IowaScaledEngineering/mss-debug/pg/mss-debug-v2.0-8bf8608/mss-debug-drc.txt

** Drc report for /home/ndholmes/data/projects/mss-debug/kicad/mss-debug/mss-debug.kicad_pcb **
** Created on 2024-08-26 14:05:44 **

** Found 0 DRC violations **

** Found 0 unconnected pads **

** Found 0 Footprint errors **

** End of Report **
