IowaScaledEngineering/mss-debug/pg/mss-debug-v2.0-8bf8608/mss-debug.pdf

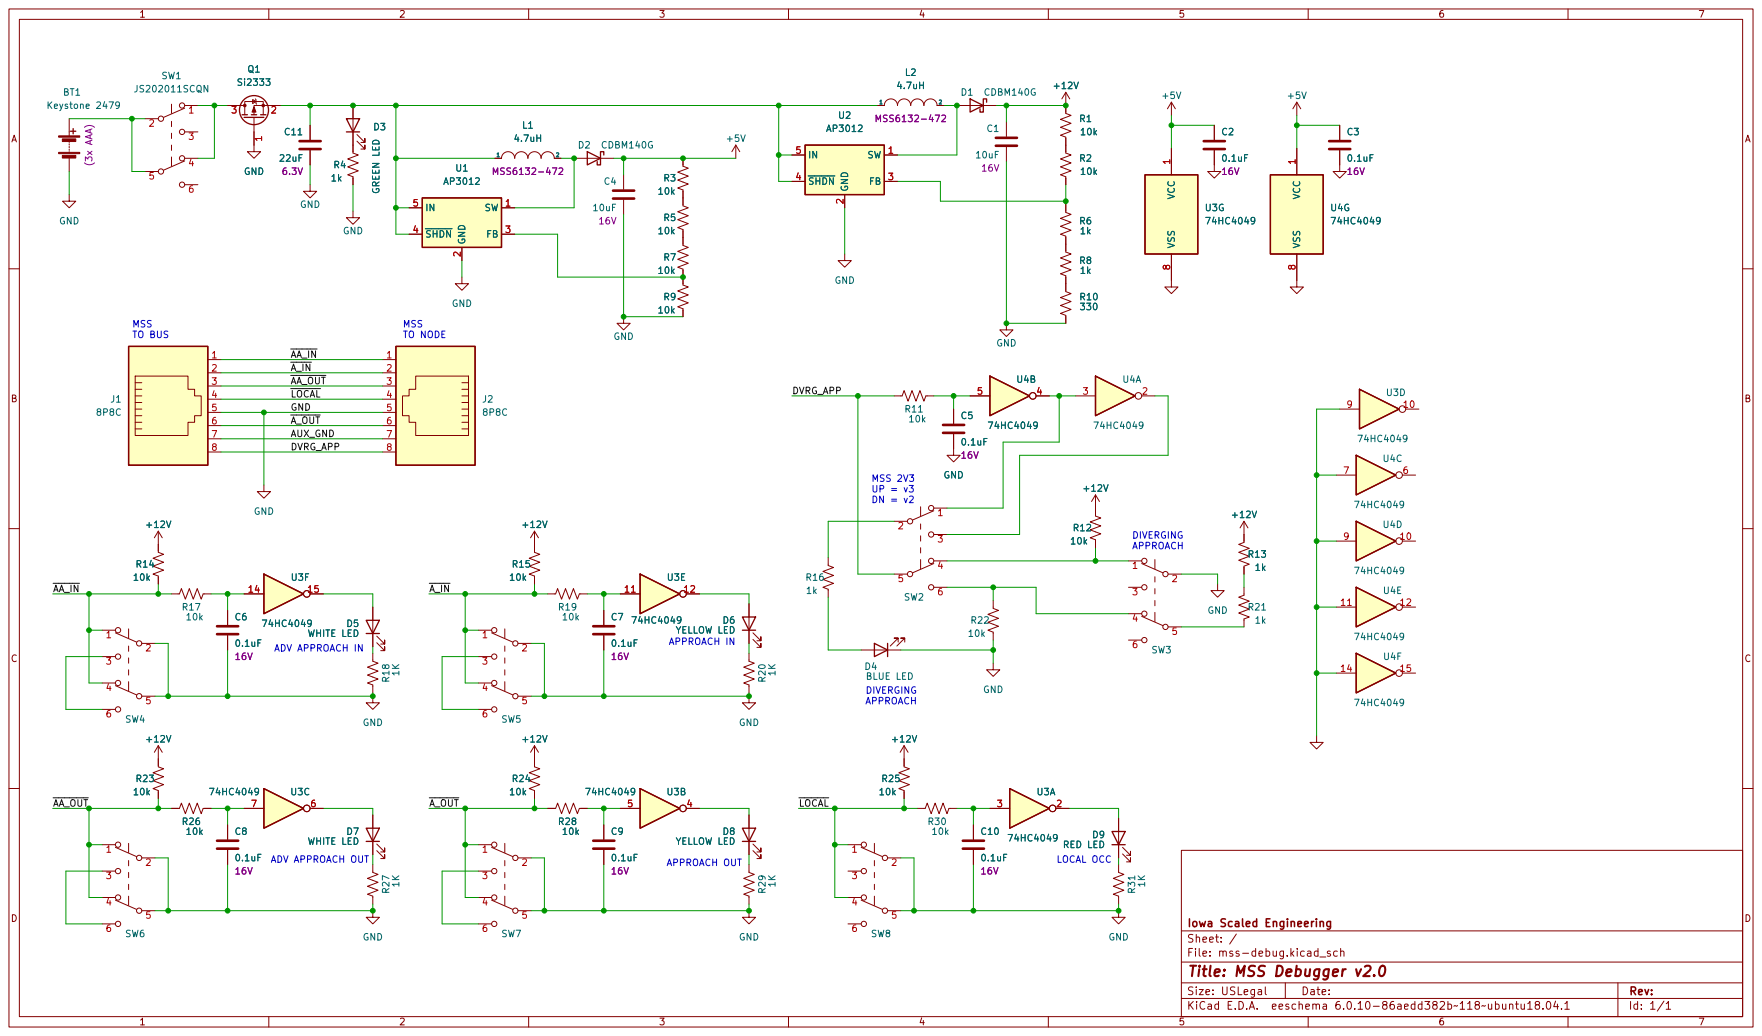
[picture p1: page 1]

ADV APPROACH IN MSS
TO BUS

6 | ~{A_OUT} 6

Iowa Scaled Engineering
File: mss-debug.kicad_sch Sheet: /
Id: 1/1 Title: MSS Debugger v2.0
