IowaScaledEngineering/mss-debug/pg/mss-debug-v1.0-e24eb0f/mss-debug-pcb.pdf

# mss-debug.pcb

# 1. Table of Contents (This Page) Created on Wed Jun 8 13:53:43 2016

# 2. component 3. solder 4. outline 5. plated-drill 6. componentmask 7. soldermask 8. topsilk 9. bottomsilk 10. toppaste 11. topassembly 12. bottomassembly 13. fab

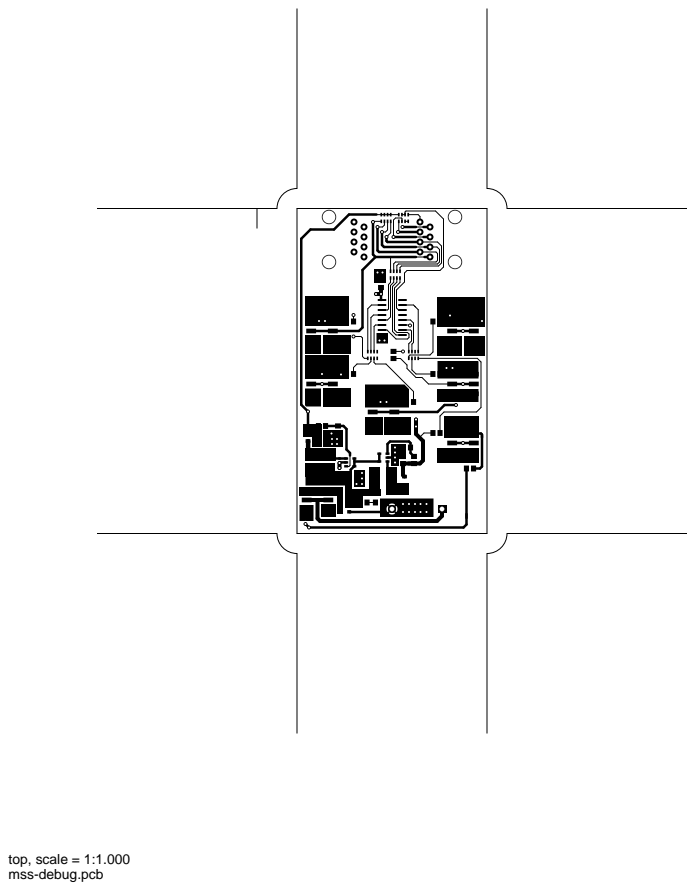
[picture p2: page 2]
top, scale = 1:1.000

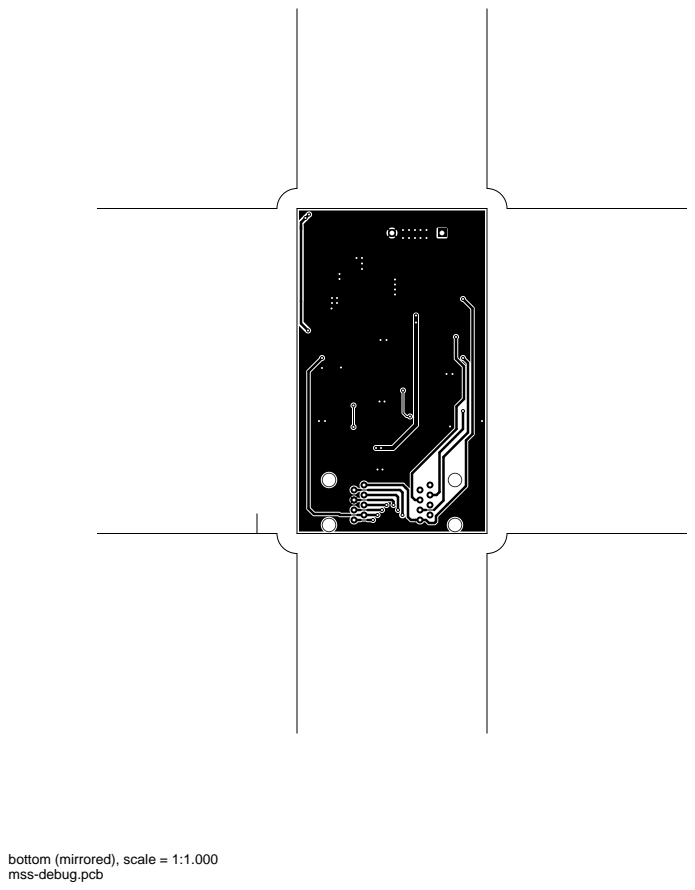
[picture p3: page 3]

bottom (mirrored), scale = 1:1.000

outline, scale = 1:1.000

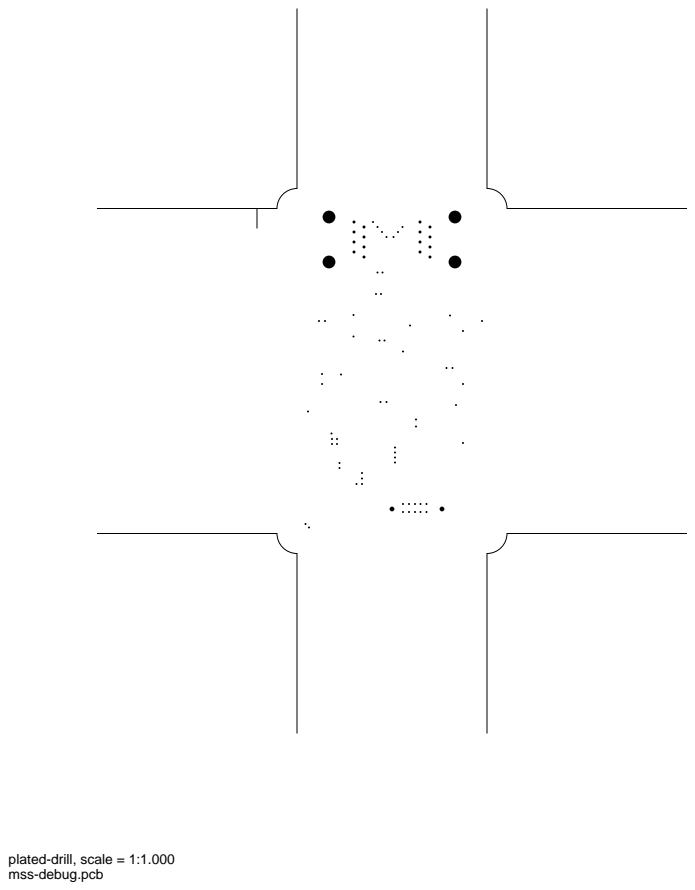
[picture p4: page 5]

plated-drill, scale = 1:1.000

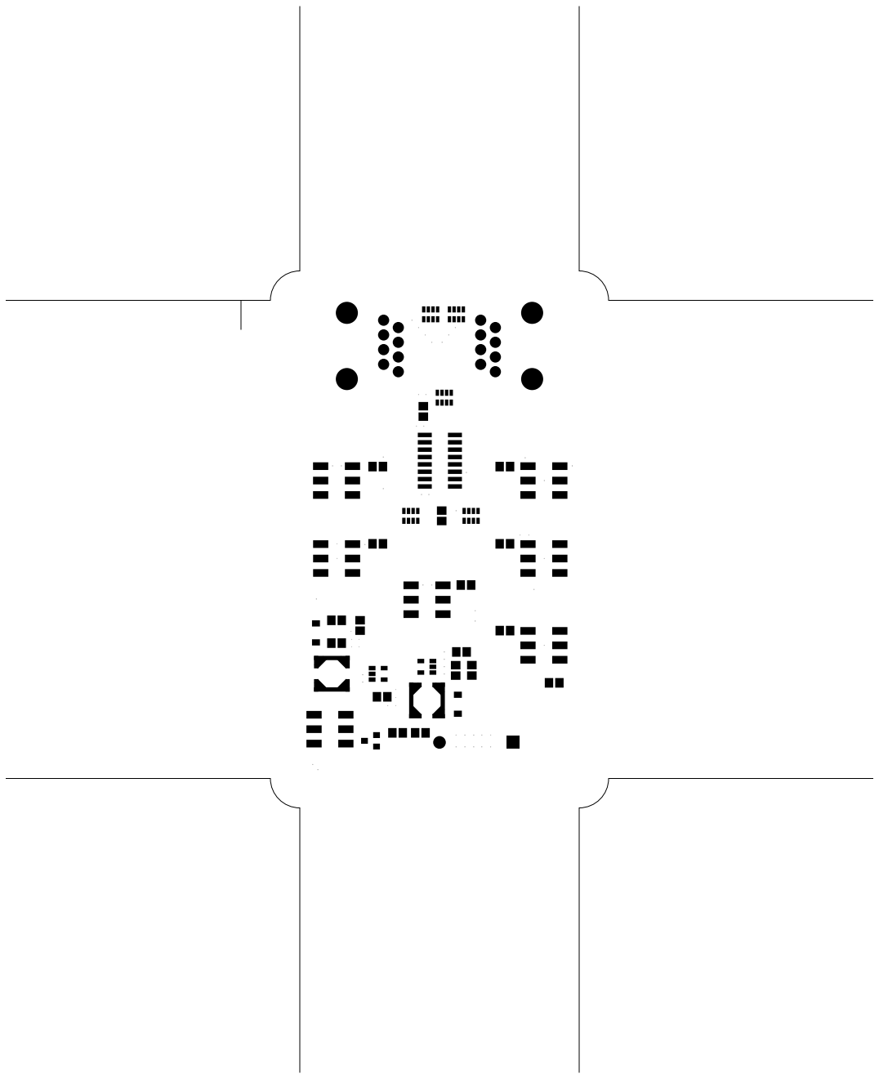
[picture p5: figure]

topmask, scale = 1:1.000

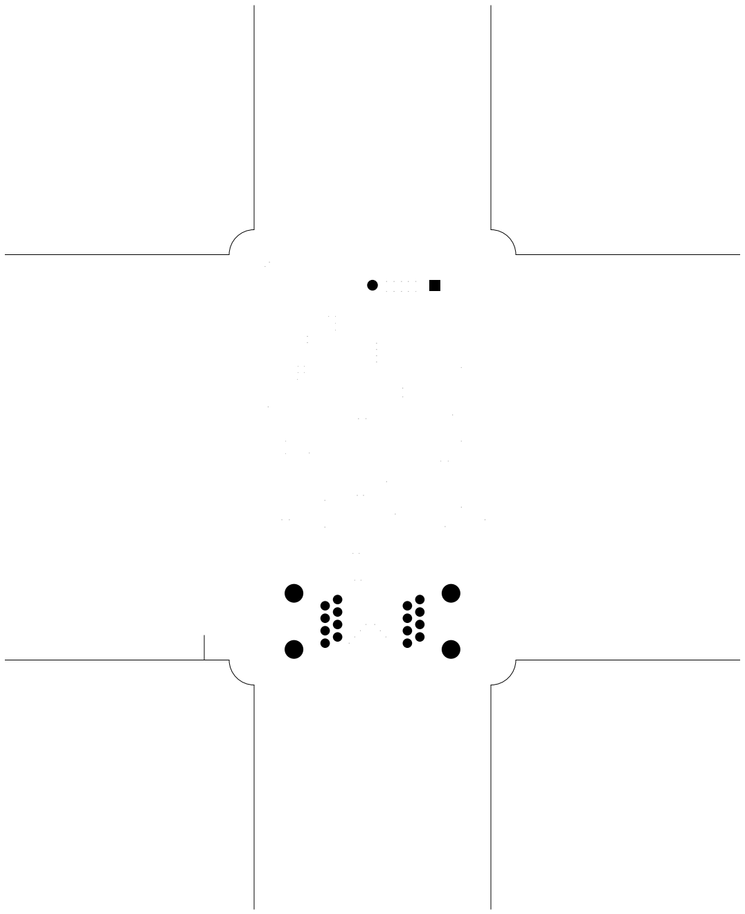
[picture p6: figure]

bottommask (mirrored), scale = 1:1.000

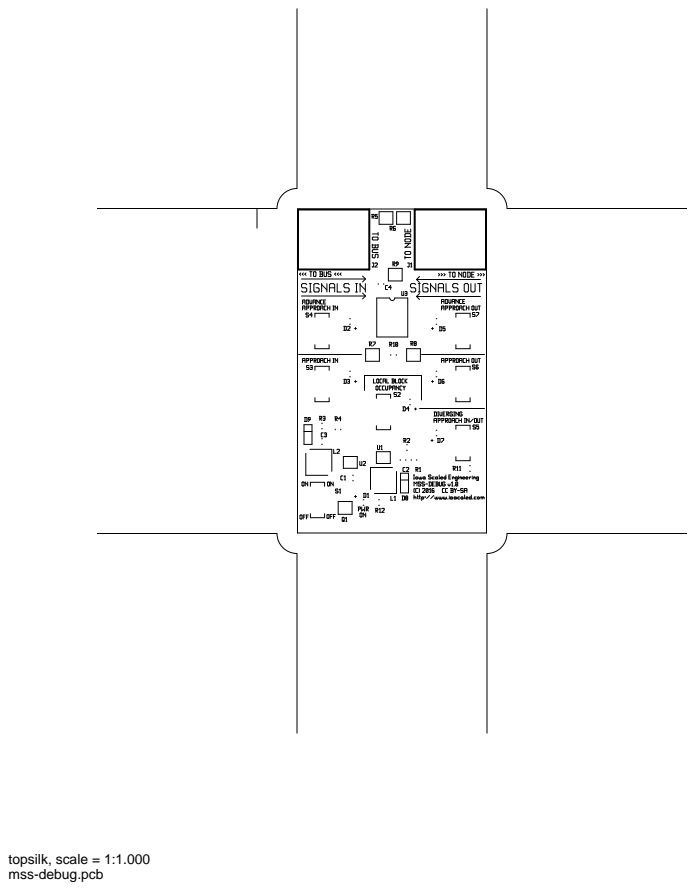
[picture p7: page 8]
topsilk, scale = 1:1.000

bottomsilk (mirrored), scale = 1:1.000

toppaste, scale = 1:1.000

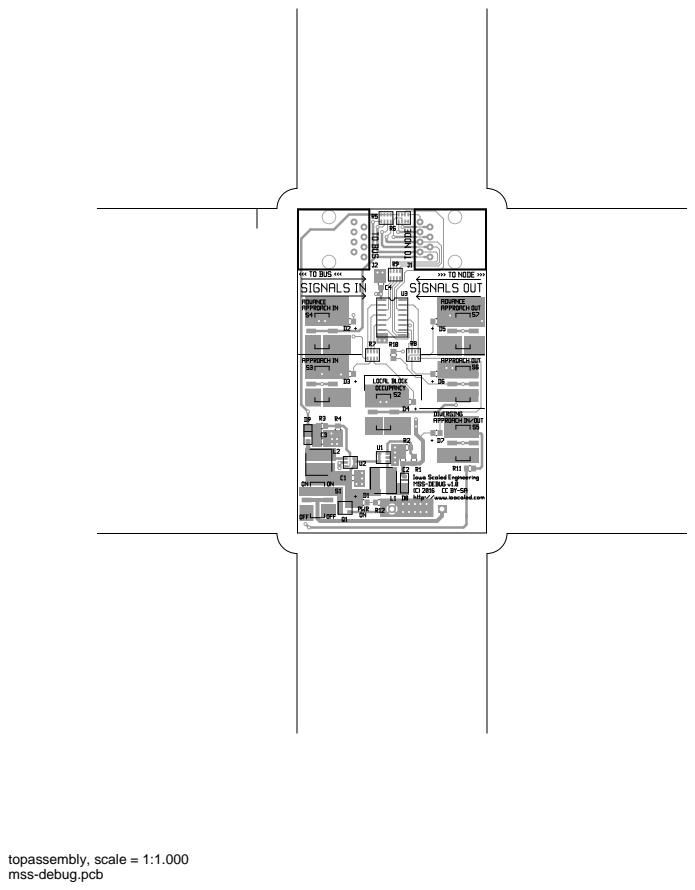
[picture p8: page 11]
topassembly, scale = 1:1.000

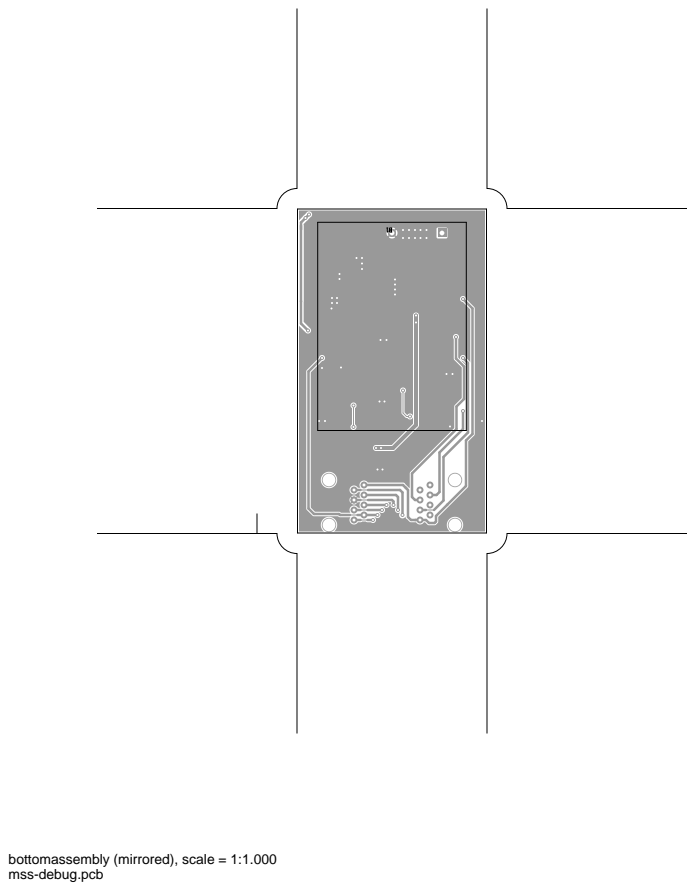
[picture p9: page 12]

bottomassembly (mirrored), scale = 1:1.000

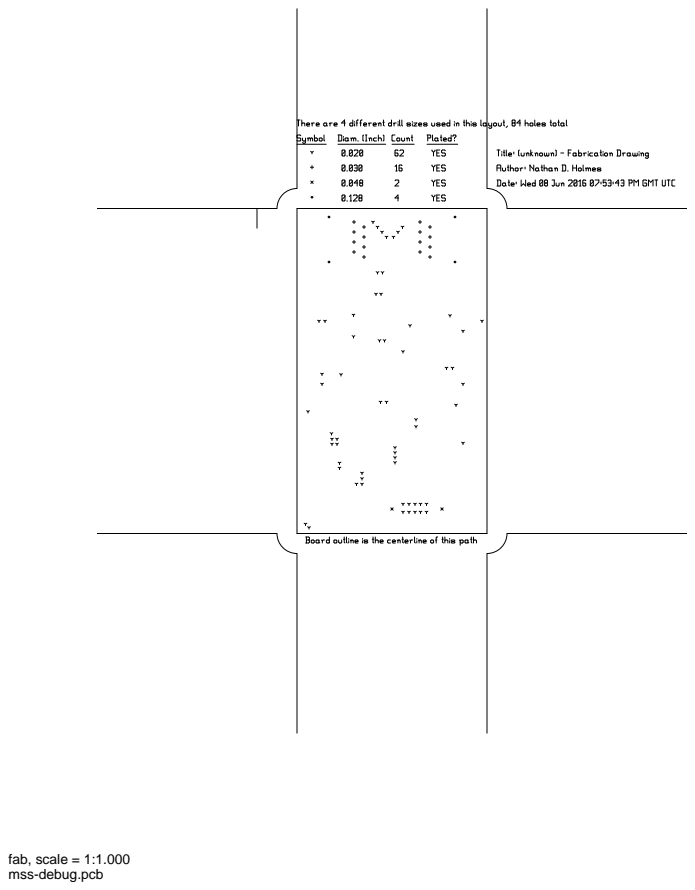
[picture p10: page 13]
fab, scale = 1:1.000
