IowaScaledEngineering/mss-debug/pg/mss-debug-v1.0-e24eb0f/mss-debug.pdf

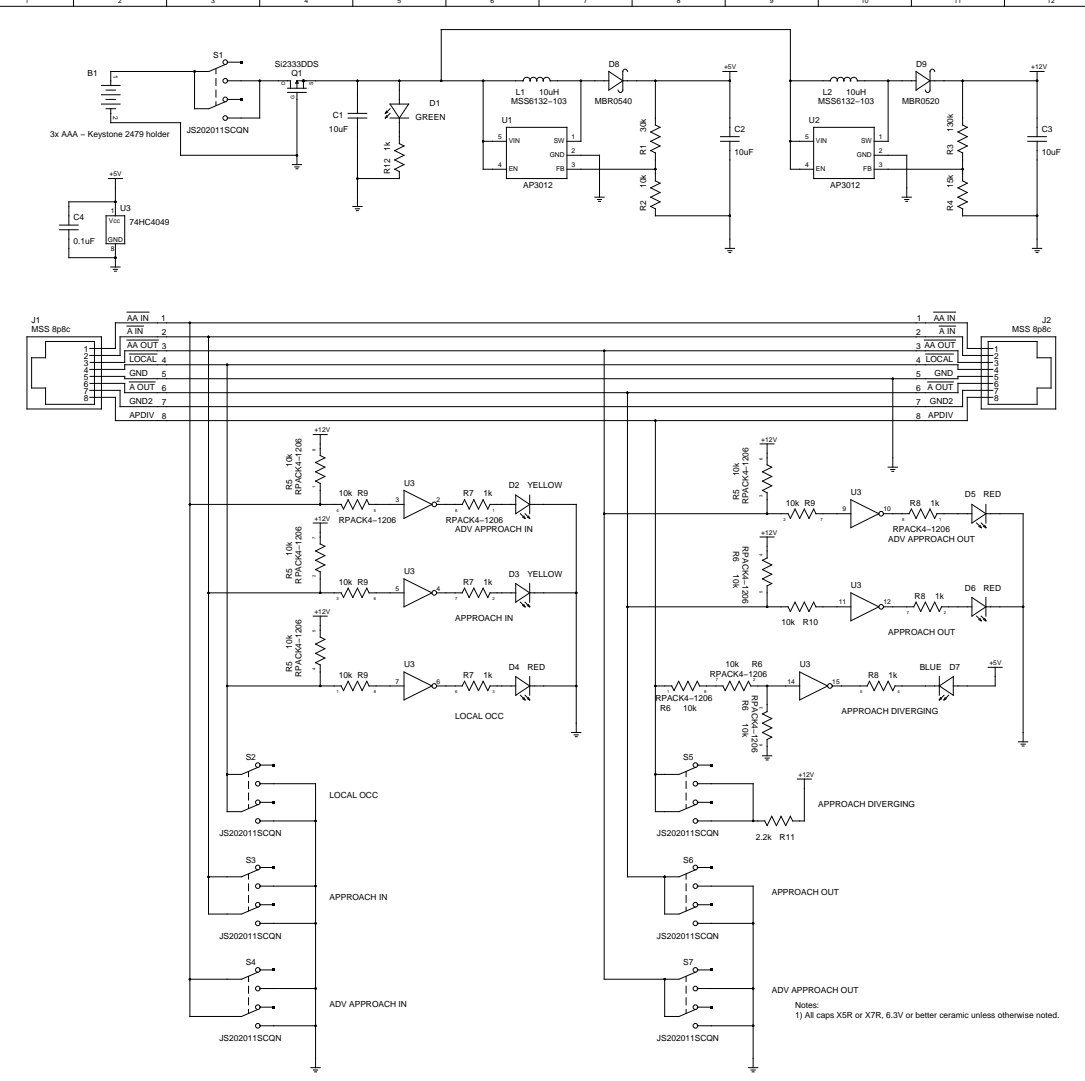
[picture p11: page 1]

ADV APPROACH OUT
Notes:
1) All caps X5R or X7R, 6.3V or better ceramic unless otherwise noted.

I2C Modular Signal System Bus Interface
mss−i2c.sch
