IowaScaledEngineering/mss-debug/(list of files, drawings)

Other design files:
pcb/mss-debug.pcb
