IowaScaledEngineering/mss-debug/kicad/mss-debug/mss-debug.kicad_pcb

## KiCad design kicad/mss-debug/mss-debug.kicad_pcb (2024-08-18)

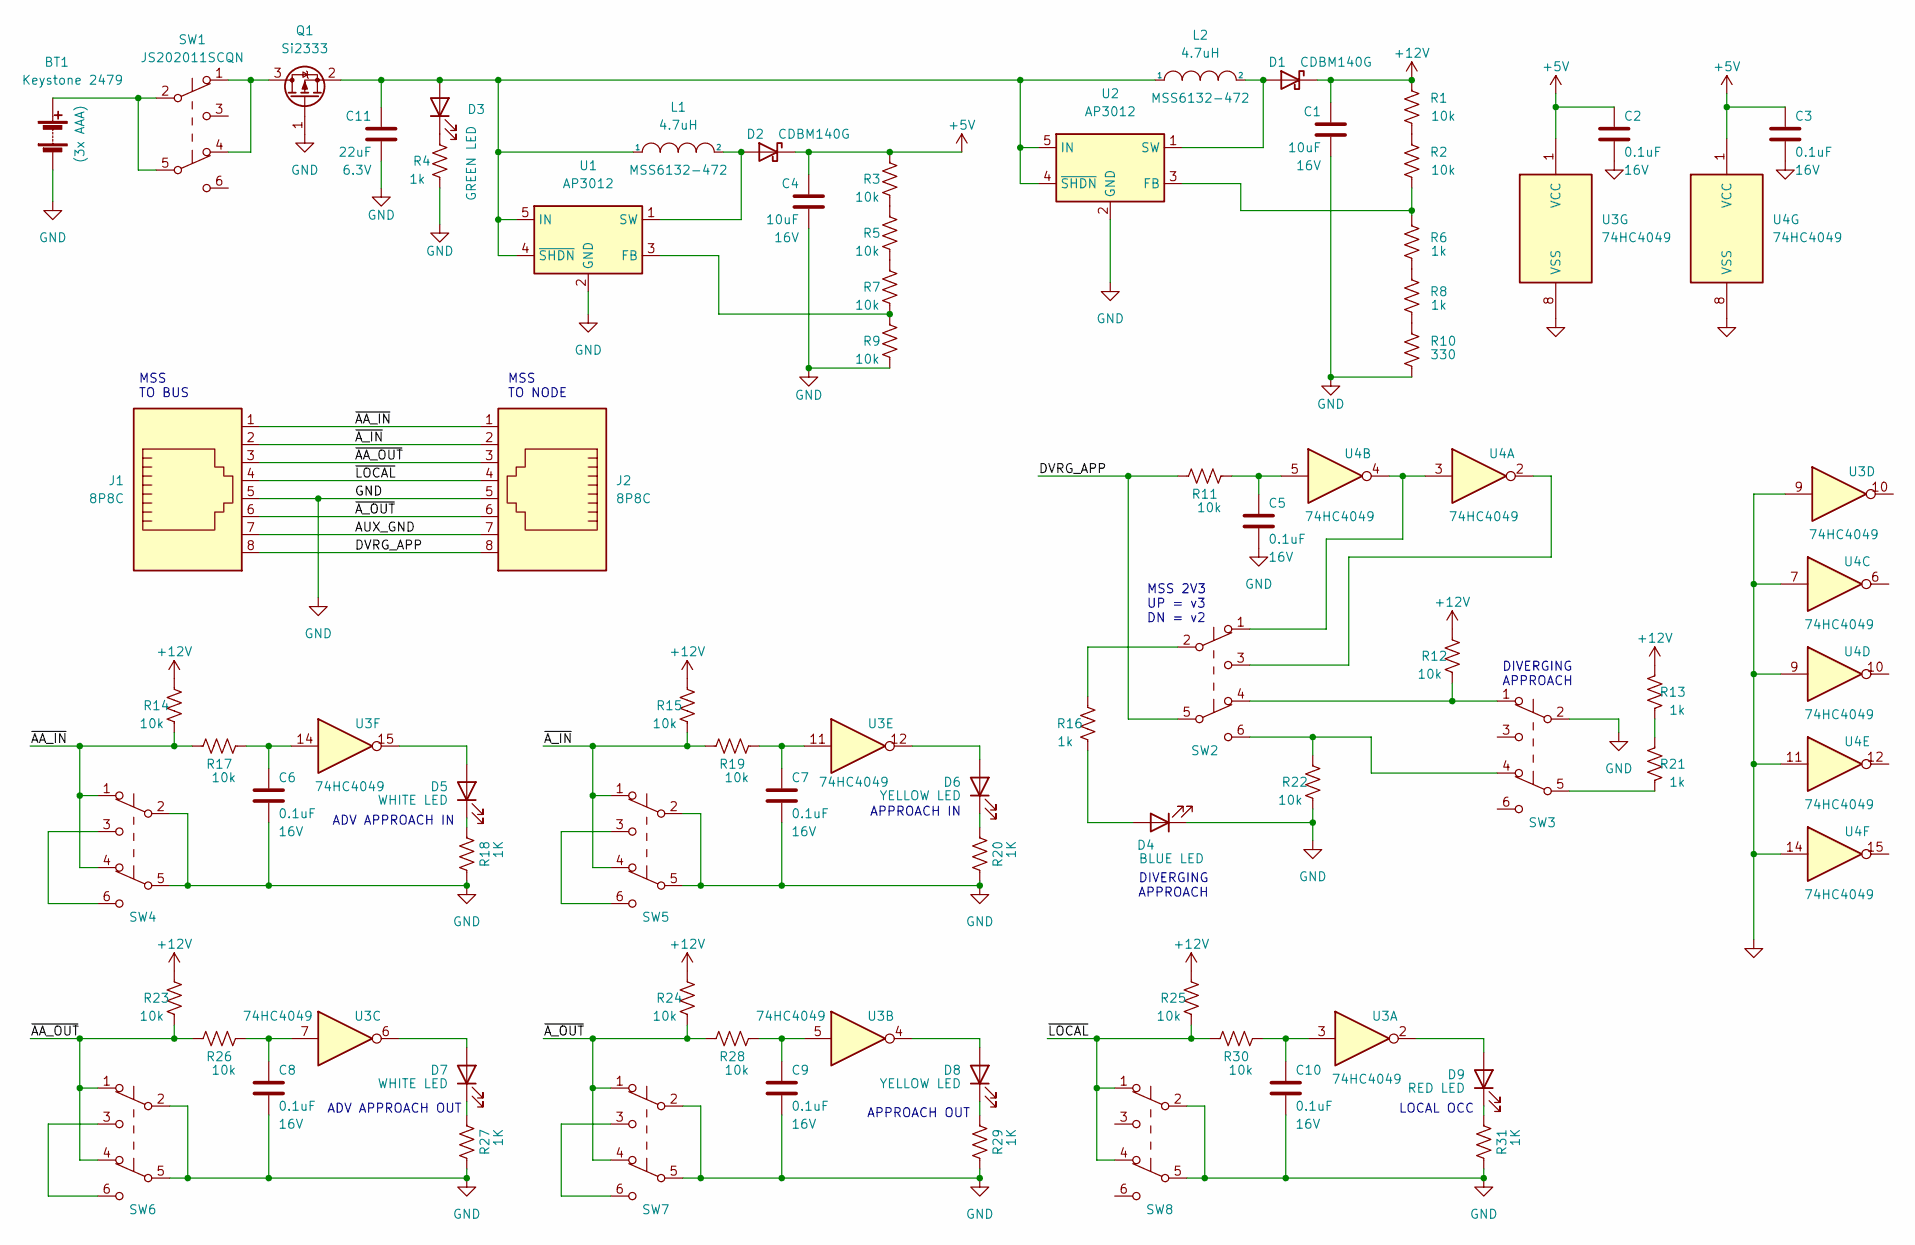
[picture p12: schematic mss-debug.kicad_sch, MSS Debugger v2.0]

Parts:
BT1: Keystone 2479; BatteryHolder_Keystone_2479_3xAAA
C1, C4: 10uF; C_0805_2012Metric; Voltage 16V
C2, C3, C5, C6, C7, C8, C9, C10: 0.1uF; C_0805_2012Metric; Voltage 16V
C11: 22uF; C_0805_2012Metric; Voltage 6.3V
D1, D2: CDBM140G; SOD-123T
D3: GREEN LED; LED_0805_2012Metric
D4: BLUE LED; LED_0805_2012Metric
D5, D7: WHITE LED; LED_0805_2012Metric
D6, D8: YELLOW LED; LED_0805_2012Metric
D9: RED LED; LED_0805_2012Metric
J1, J2: 8P8C; RJ45_Amphenol_54602-x08_Horizontal
L1, L2: 4.7uH; MSS6132-xxxMLC
Q1: Si2333; SOT-23
R1, R2, R3, R5, R7, R9, R11, R12, R14, R15, R17, R19, R22, R23, R24, R25, R26, R28, R30: 10k; R_0805_2012Metric
R4, R6, R8, R13, R16, R21: 1k; R_0805_2012Metric
R10: 330; R_0805_2012Metric
R18, R20, R27, R29, R31: 1K; R_0805_2012Metric
SW1, SW2, SW3, SW4, SW5, SW6, SW7, SW8: JS202011SCQN; SW_JS202011SCQN
U1, U2: AP3012; SOT-23-5
U3, U4: 74HC4049; SO-16_3.9x9.9mm_P1.27mm

Connections:
+5V: C2.1, C3.1, C4.1, D2.1 (K), R3.2, U3.1 (VCC), U4.1 (VCC)
+12V: C1.1, D1.1 (K), R1.2, R12.2, R13.2, R14.2, R15.2, R23.2, R24.2, R25.2
/AUX_GND: J1.7, J2.7
/DVRG_APP: J1.8, J2.8, R11.2, SW2.5 (B)
/~AA_IN: J1.1, J2.1, R14.1, R17.2, SW4.1 (A), SW4.4 (A); also elsewhere on the board
/~AA_OUT: J1.3, J2.3, R23.1, R26.2, SW6.1 (A), SW6.4 (A)
/~A_IN: J1.2, J2.2, R15.1, R19.2, SW5.1 (A), SW5.4 (A)
/~A_OUT: J1.6, J2.6, R24.1, R28.2, SW7.1 (A), SW7.4 (A)
/~LOCAL: J1.4, J2.4, R25.1, R30.2, SW8.1 (A), SW8.4 (A)
GND: BT1.2 (-), C1.2, C2.2, C3.2, C4.2, C5.2, C6.2, C7.2, C8.2, C9.2, C10.2, C11.2, D4.1 (K), J1.5, J2.5, Q1.1 (G), R4.1, R9.1, R10.1, R18.2, R20.2, R22.1, R27.2, R29.2, R31.2, SW3.2 (B), SW4.2 (B), SW4.5 (B), SW5.2 (B), SW5.5 (B), SW6.2 (B), SW6.5 (B), SW7.2 (B), SW7.5 (B), SW8.2 (B), SW8.5 (B), U1.2 (GND), U2.2 (GND), U3.8 (VSS), U3.9, U4.7, U4.8 (VSS), U4.9, U4.11, U4.14; also elsewhere on the board
unnamed: C5.1, R11.1, U4.5
unnamed: C6.1, R17.1, U3.14
unnamed: C7.1, R19.1, U3.11
unnamed: C8.1, R26.1, U3.7
unnamed: C9.1, R28.1, U3.5
unnamed: C10.1, R30.1, U3.3
unnamed: D3.1 (K), R4.2
unnamed: D4.2 (A), R16.1
unnamed: D5.2 (A), U3.15
unnamed: D6.2 (A), U3.12
unnamed: D7.2 (A), U3.6
unnamed: D8.2 (A), U3.4
unnamed: D9.1 (K), R31.1
unnamed: D9.2 (A), U3.2
unnamed: D1.2 (A), L2.2, U2.1 (SW)
unnamed: R1.1, R2.2
unnamed: R3.1, R5.2
unnamed: R5.1, R7.2
unnamed: R6.1, R8.2
unnamed: R8.1, R10.2
unnamed: R12.1, SW2.4 (A), SW3.1 (A)
unnamed: R13.1, R21.2
unnamed: R16.2, SW2.2 (B)
unnamed: D5.1 (K), R18.1
unnamed: D6.1 (K), R20.1
unnamed: R21.1, SW3.5 (B)
unnamed: R22.2, SW2.6 (C), SW3.4 (A)
unnamed: D7.1 (K), R27.1
unnamed: D8.1 (K), R29.1
unnamed: Q1.3 (D), SW1.1 (A), SW1.4 (A)
unnamed: BT1.1 (+), SW1.2 (B), SW1.5 (B)
unnamed: SW2.1 (A), U4.3, U4.4
unnamed: SW2.3 (C), U4.2
unnamed 43: SW4.3 (C), SW4.6 (C); also elsewhere on the board
unnamed: SW5.3 (C), SW5.6 (C)
unnamed: SW6.3 (C), SW6.6 (C)
unnamed: SW7.3 (C), SW7.6 (C)
unnamed: D2.2 (A), L1.2, U1.1 (SW)
unnamed: R7.1, R9.2, U1.3 (FB)
unnamed: C11.1, D3.2 (A), L1.1, L2.1, Q1.2 (S), U1.4 (~SHDN), U1.5 (IN), U2.4 (~SHDN), U2.5 (IN)
unnamed: R2.1, R6.2, U2.3 (FB)

Notes on the sheet:
MSS TO BUS
APPROACH IN
DIVERGING APPROACH
MSS TO NODE
ADV APPROACH OUT
APPROACH OUT
ADV APPROACH IN
LOCAL OCC
MSS 2V3 UP = v3 DN = v2

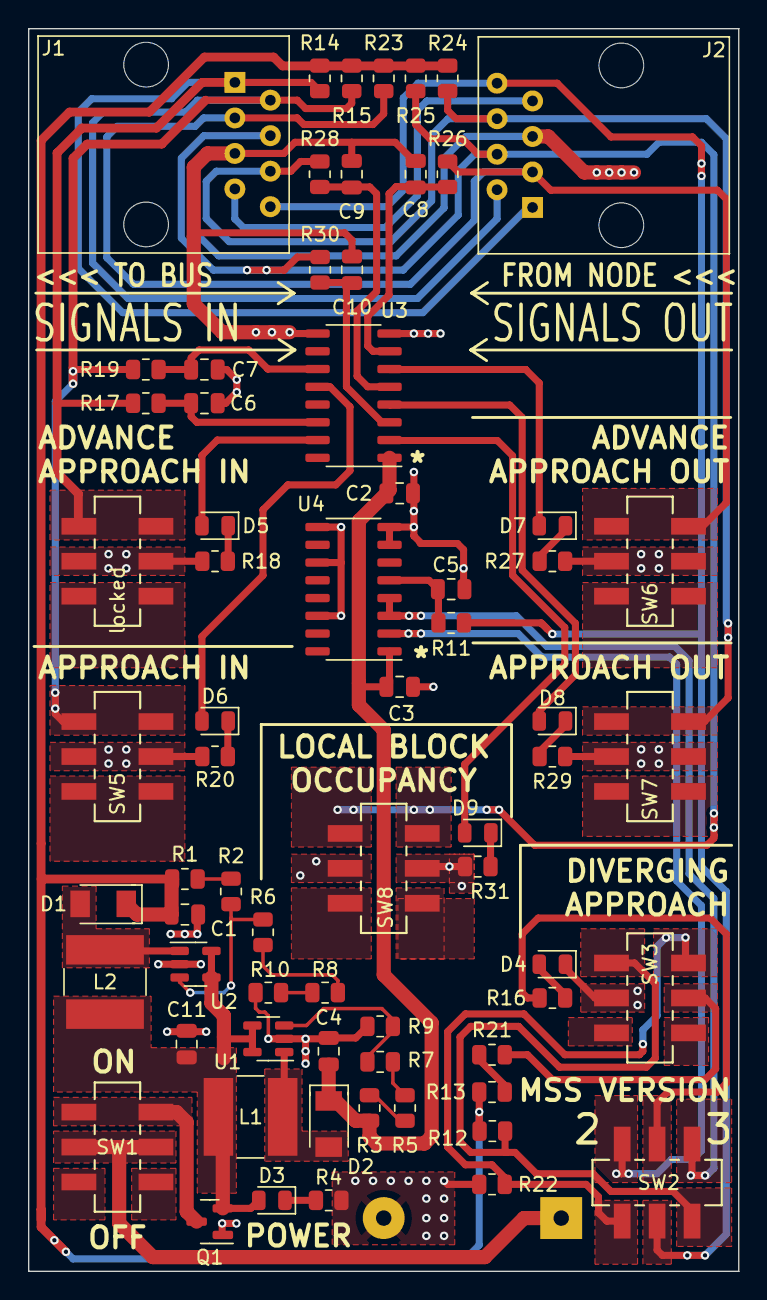
[picture p13: board mss-debug.kicad_pcb from above]

Board: 2 copper layers, 50.8 x 88.9 mm, 69 parts (1 on the bottom side), 51 nets.

Other parts of the board:
locked: JS202011SCQN; SW_JS202011SCQN

Their connections:
/~AA_IN: locked.1 (A), locked.4 (A); also elsewhere on the board
GND: locked.2 (B), locked.5 (B); also elsewhere on the board
unnamed 43: locked.3 (C), locked.6 (C); also elsewhere on the board
