IowaScaledEngineering/mss-debug/doc/debug-bag-top.odt

Iowa Scaled Engineering, LLC

http://iascaled.com/


Modular Signaling System
Debug Module

The MSS-DEBUG is used to test Modular Signaling System (MSS) components. It sends and receives signals over the MSS bus to test standalone modules or debug problems in signal installations.

MSS-DEBUG
