IowaScaledEngineering/mss-debug/doc/images/mss-debug-pcb.png

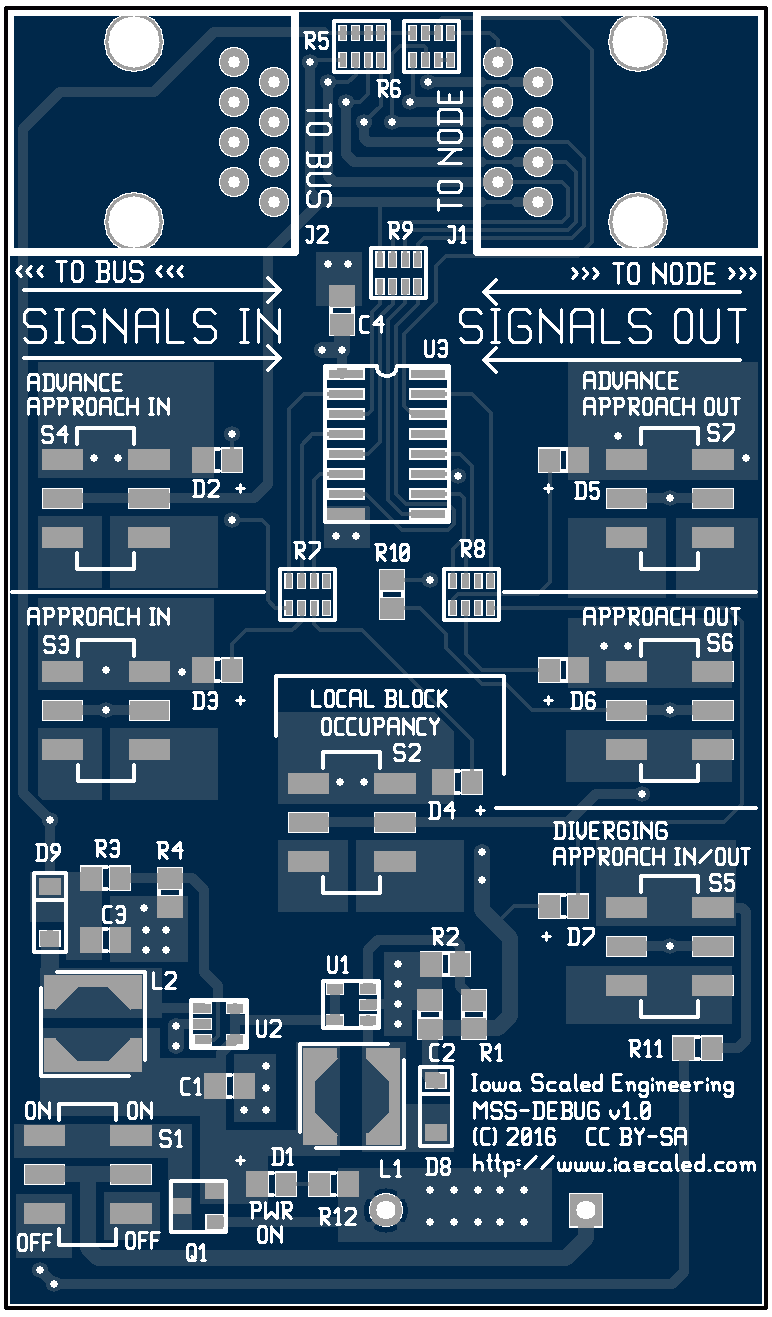
doc/images/mss-debug-pcb.png
