IowaScaledEngineering/mss-debug/(commit log)

2016-06-08 Initial version
    [mss-debug.pcb, mss-debug.sch]
2016-06-08 Add more copper around the switches for mechanical stability
    [mss-debug.pcb]
2016-06-08 Added a bit more copper plane around the 5V regulator
    [mss-debug.pcb]
2016-06-08 Add pg of 1.0
    [mss-debug.bottom.gbr, mss-debug.bottommask.gbr, mss-debug.bottompaste.gbr, mss-debug.bottomsilk.gbr, mss-debug.fab.gbr, mss-debug.outline.gbr, mss-debug.top.gbr, mss-debug.topmask.gbr]
2016-09-27 Add PCB drawing and manual
2016-11-29 Fixed schematic
    [mss-debug.sch]
2022-06-25 Update border on schematic so I didn't go blind trying to read it
    [mss-debug.sch]
2024-08-17 Start on v2 of the debug in kicad
    [mss-debug.kicad_pcb, mss-debug.kicad_sch]
2024-08-18 Initial cut of the 2.0 board
    [mss-debug.kicad_pcb, mss-debug.kicad_sch]
2024-08-18 Fix back text
    [mss-debug.kicad_pcb]
2024-08-26 pg debug 2.0
    [mss-debug-NPTH.drl, mss-debug.drl, mss-debug.gbl, mss-debug.gbo, mss-debug.gbp, mss-debug.gbr, mss-debug.gbs, mss-debug.gm1]
