IowaScaledEngineering/mss-debug/(notices)

Notices in the files:
kicad/mss-debug/mss-debug.kicad_pcb:
www.iascaled.com ©2024
